fhk/plantz/README.md

# plantz
An example project and code to run a greenhouse (or maybe a local food revolution ...).

As always it's a Work In Progress (WIP).

Checkout the Twitch stream [coming soon] https://twitch.com

You can even fund some projects and the ongoing development of the urban distributed agriculutre concept. Sign up via Patreon [coming soon] https://patreon.com

As demand grows for high quality produce and the thirst for robust low impact supply chains expands a number of projects are being created to commercialize and educate the consumer. However, everyone should be able to create their own sustainable food source.

Some examples include:

- Paris, France - Agricool
- Bay Area, United States -
- MIT food computer V1, V2, V3 [link](https://wiki.openag.media.mit.edu/)
- Oroborus
- Monterey
- NY
- (Please add)

## What is Aquaponics?

TBC [link](https://www.youtube.com/watch?v=df5OrJptsWU)

## The Plan - v0.1 Backyard Greenhouse

### Lessons learnt

1. Insulate where possible the sump tank
2. It's very hard to holesaw PVC, try to use fittings instead
3. Assume you don't have wifi
4. Ensure you have multiple water routes
5. Design your circuits
6. You are at the mercy of water temp

### Planning

Prep the area, level it put down wire. Then create a frame to house the gravel/rock.

### Materials

1. 20 x 10ft Shelter Logic extra high greenhouse
2. 2" PVC pipe
4. 4 x 300 Gal. IBCs
5. 2 x 50 Gal. barrels with removable lids
6. 2 x 3-500 Gal. tanks
7. 1 x 20 Gal. Bucket
8. 20 x UniSeals
9. Rock/Media
10. Dow Blue Board Foam
11. 2" PVC Couplers
12. 2" PVC Ts
13. 2" PVC X
14. 4 x 2" PVC union joints
15. 4 x 2" PVC male threads
16. 2" PVC 90'
17. 2" to 3/4" adapter female to male
18. 4 x 3/4" X manifold female 
19. 12 x 12v 3/4" solenoid / Function wise it may be better to just get the 2" Krain 24V valves
20. Solderable bread board
21. Male and Femal terminals crimp on
22. Red and Black small gauge wire
23. Multi Colored medium gauge wire
24. 2 X Sparkfun Particle Photon
25. 12v Power supply
26. 5V activated 4 Relay board
27. 2 x Xaomi ip cameras
28. 4 x temp prope
29. 1 x humidity prope
30. Pure loctite silicone (No anti-fungal agents)
31. Bio balls
32. Air pump
33. 3 x large airstones
34. Large water pump
35. 20 x Cinder blocks
36. PVC Glue - Not too hot...
37. Solder
38. Extension cable
39. Powerboard
40. 2" PVC Valves
41. 4 x Pallets
42. Chicken wire
43. 2x2" Timber to make frame for cover
44. Pool noodles
45. Hyropoinc 2" baskets
46. Rockwool cubes
47. 1 Gallon/ 4 Litres white paint
48. Dish washing liquid
49. Plumbing thread tape
50. Perlite
51. Hydroponic buckets
52. Rockwool cubes
53. Iron supplement
54. Fish food

### Tools
1. Drill
2. 2" & 3" holesaw
3. PVC pip cutter
4. Allen keys
5. Socket set
6. Skrew drivers
7. Angle grinder
8. Stanley knife
9. PH meter
10. Sand paper
11. Garden hose
12. Soldering iron
13. Pole and paint applicator
14. Sharpie
15. Pressure washer

### How to

#### The plan

The overall design evolved as it was built but I am realtivly confident that it is in a stable state now.

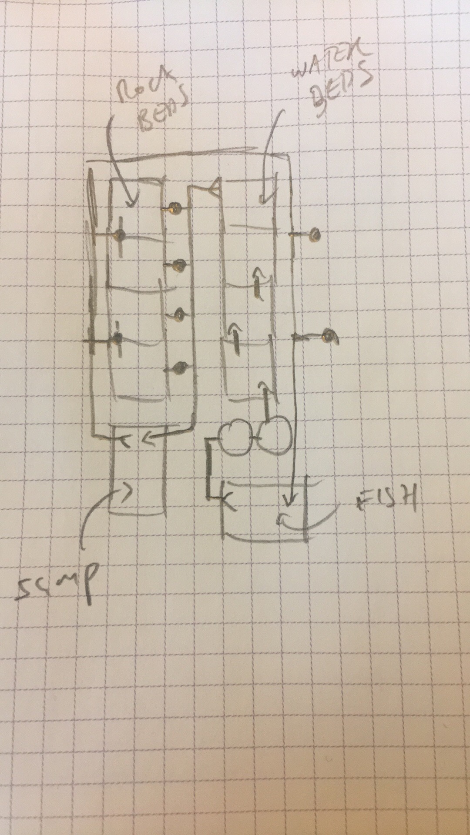
[picture p1: assets/img/IMG_4307.JPG]


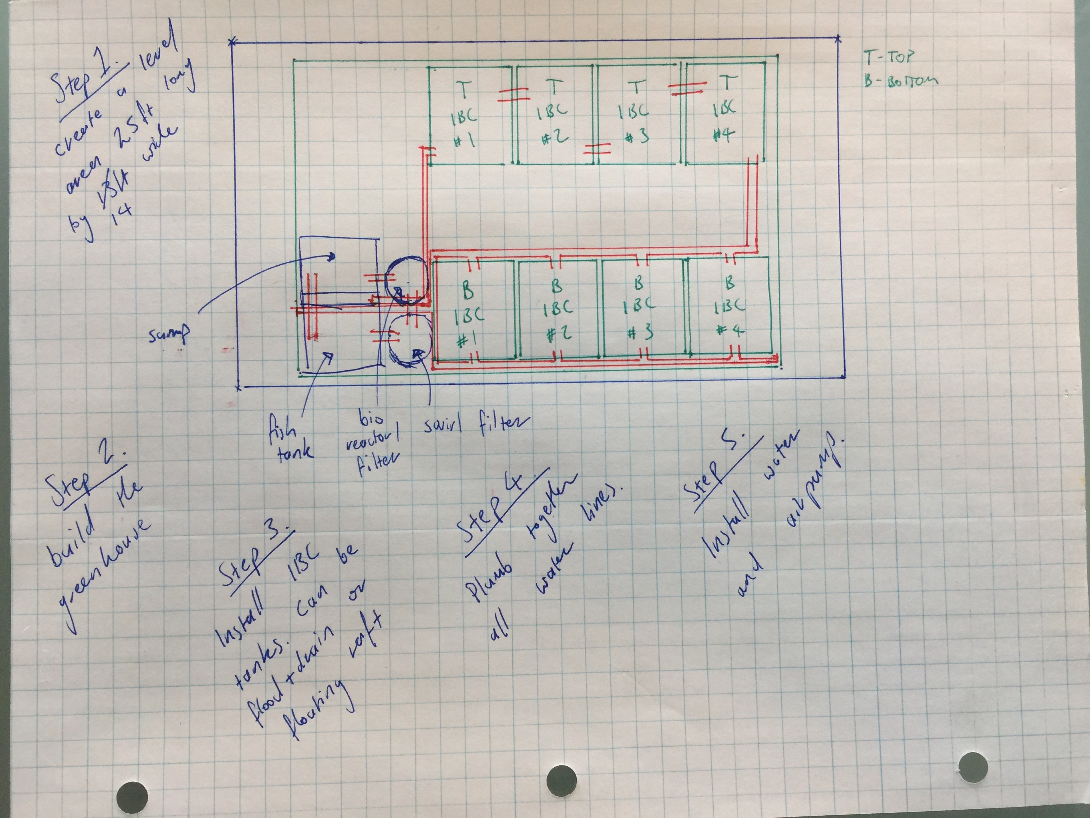
[picture p2: assets/img/IMG_1213.JPG]


#### Step 1 - Build the greenhouse

Select an area and get it levelled off and make sure the bottom is well draining.

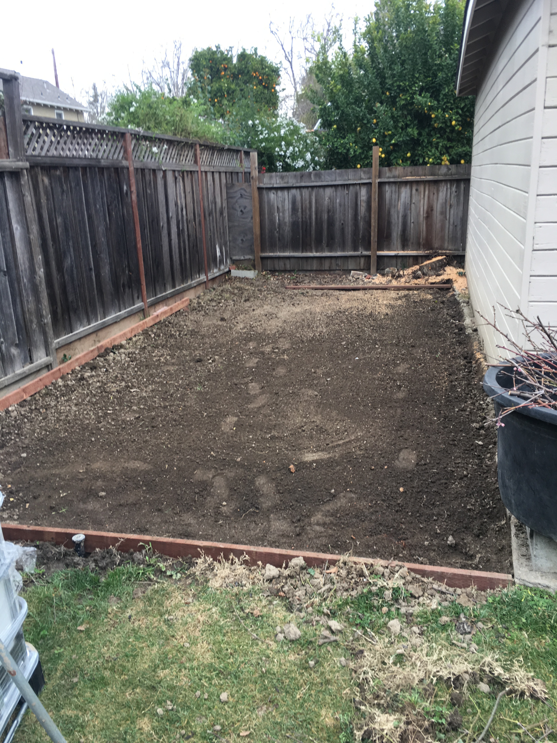
[picture p3: assets/img/IMG_4750.JPG]

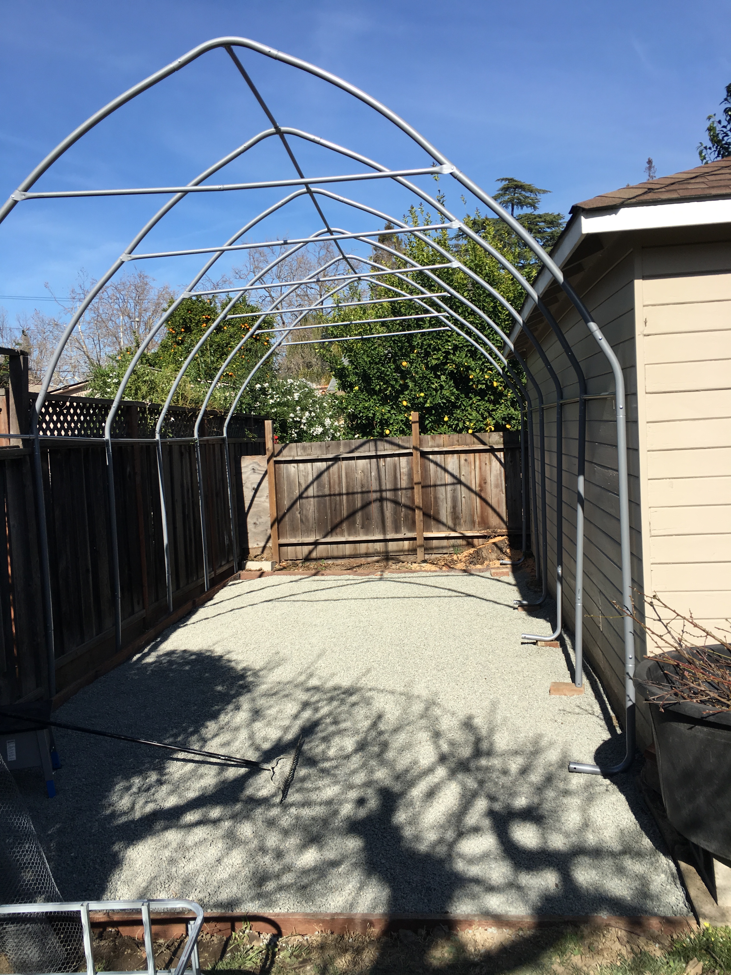
[picture p4: assets/img/IMG_9652.JPG]


This [video](https://www.youtube.com/watch?v=2YyyYJgxaFM) shows the process. Note be sure to measure the space. In our case we had to leave out one section due to a leaning fence.

You you will need at least 2 people.

#### Step 2 - Cut the IBCs in half

First be sure that they are clean. If not use a pressure washer to clean them.

1. Take the IBCs out of their metal cages - keep the metals bars as they will be used later.
2. Use a string line and sharpie to mark all 4 sides of the container.
3. Cut them with the angle grinder using a cutting disk.
4. Trim the extra metal such that it is not pertruding.
5. Mount the top half of the metal cages to the 4 pallets.
6. Replace the 1/2 IBCs into the 8 pallet holders/containers.

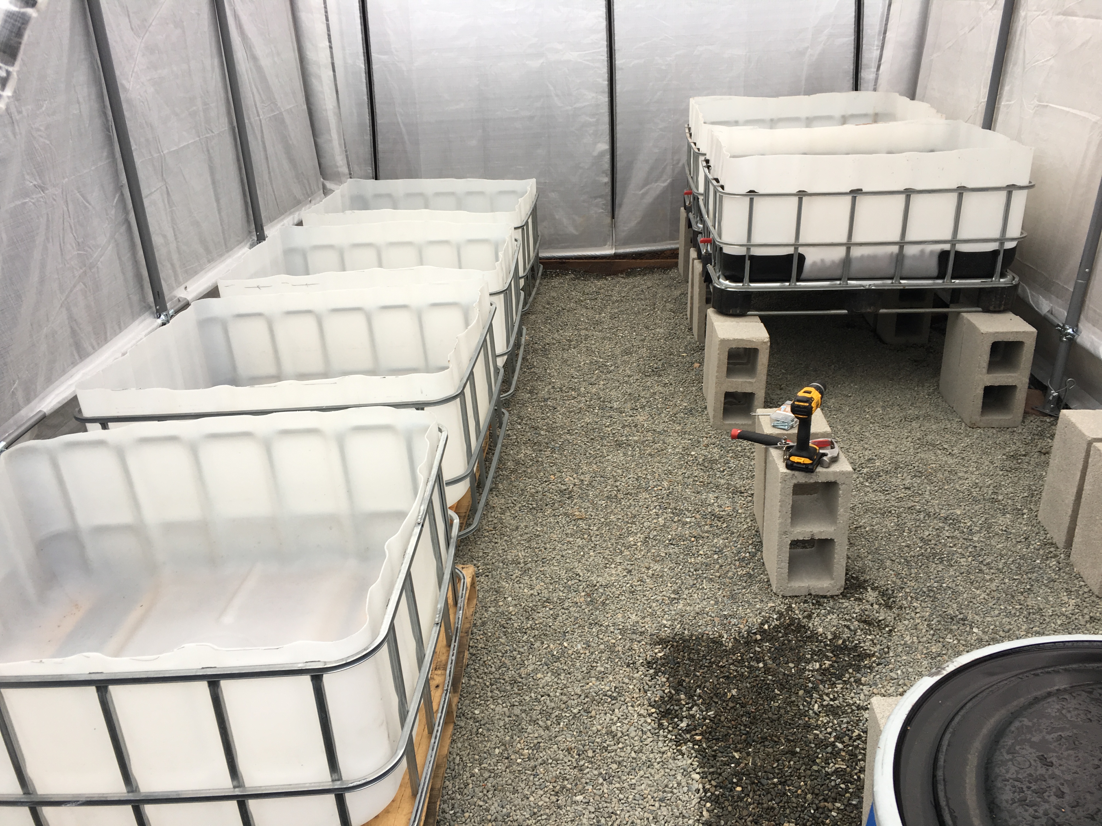
[picture p5: assets/img/IMG_3498.JPG]


#### Step 3 - Wash the rocks

Depending on what media you have selected its a great idea to wash them such that minimal debris is present.

You can use two of the IBCs and place them at an angle such that the water drains through the valve.

Use the pressure washer and add the rocks as you clean them.

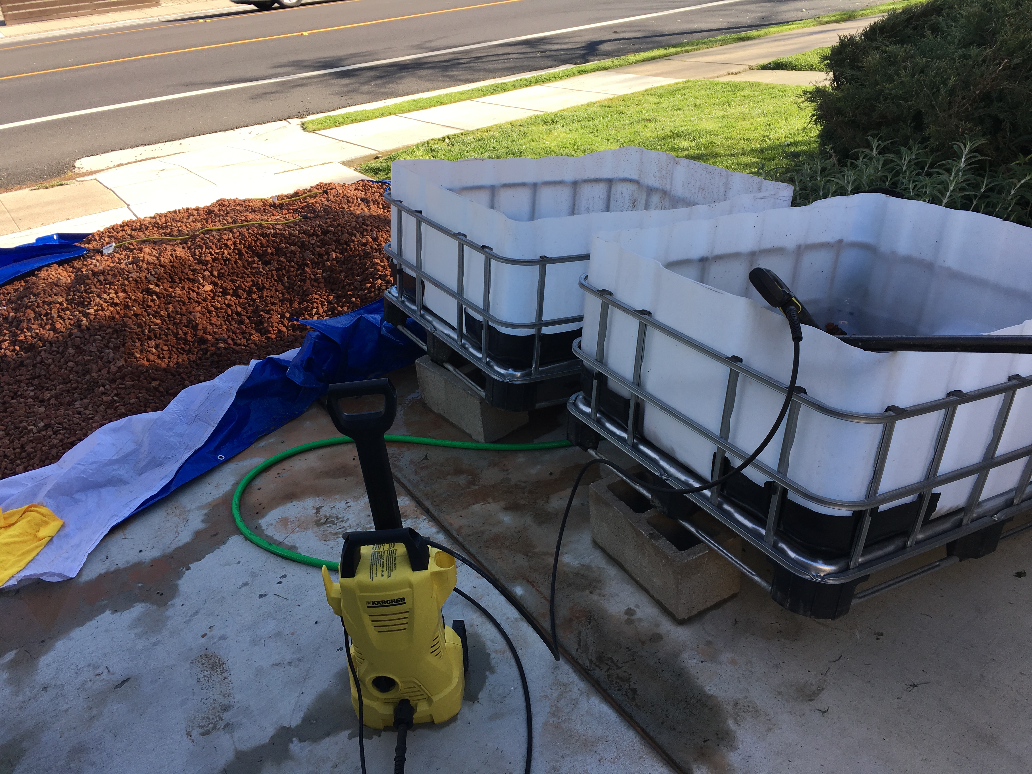
[picture p6: assets/img/IMG_0695.JPG]


#### Step 4 - Setup the water flow

Now we want to create the water flow for the setup.

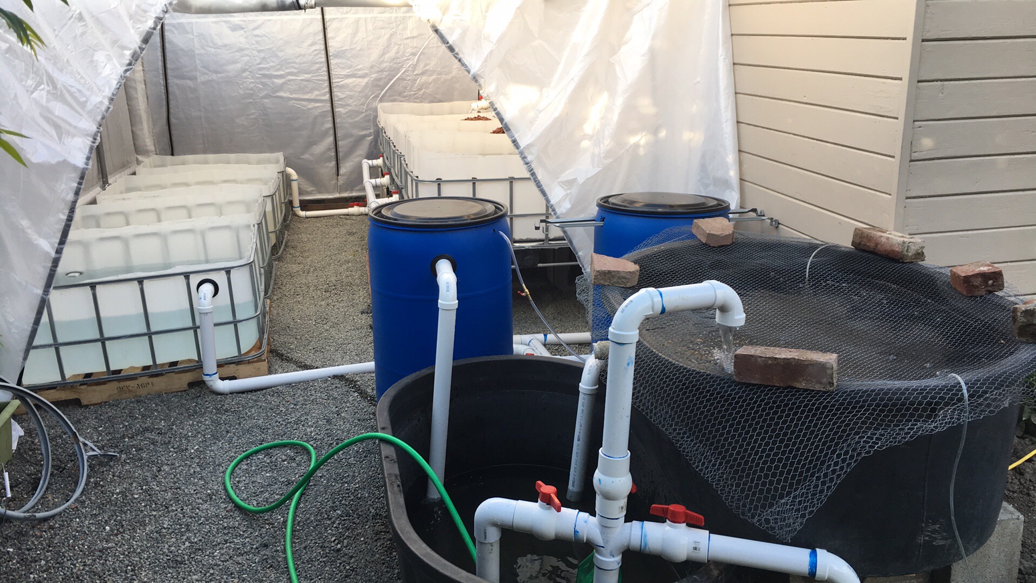
[picture p7: assets/img/IMG_4515.JPG]


1. Place the deep water culture IBCs on the side of you preference.
2. Place the cider blocks in groups of four such that you can place the IBCs with original bottoms on them.
3. Determine your water route
4. Use the holesaw to cut the desired holes
5. Install the uniseals
6. Cut the PVC to length and glue the required sections
7. Trim the PVC so that it has a taper with a stanley knife
8. Use dish soap to push the PVC through
9. Move the rock IBCs to their positions
10. Attache the union joints using thread tape to get a good seal
11. Create the top water dispenser manifold
12. Create the bottom water manifold
13. Connect the water manifolds to the tank and pump outlet
14. Create the swirl filter

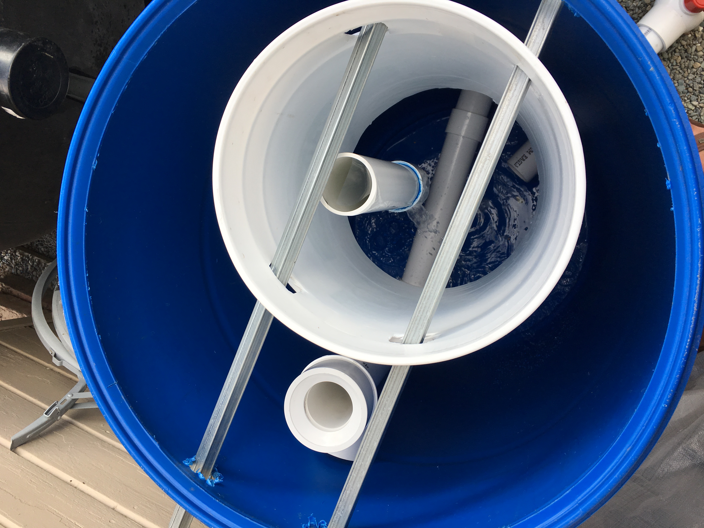
[picture p8: assets/img/IMG_2832.JPG]


15. Create the bioreactor

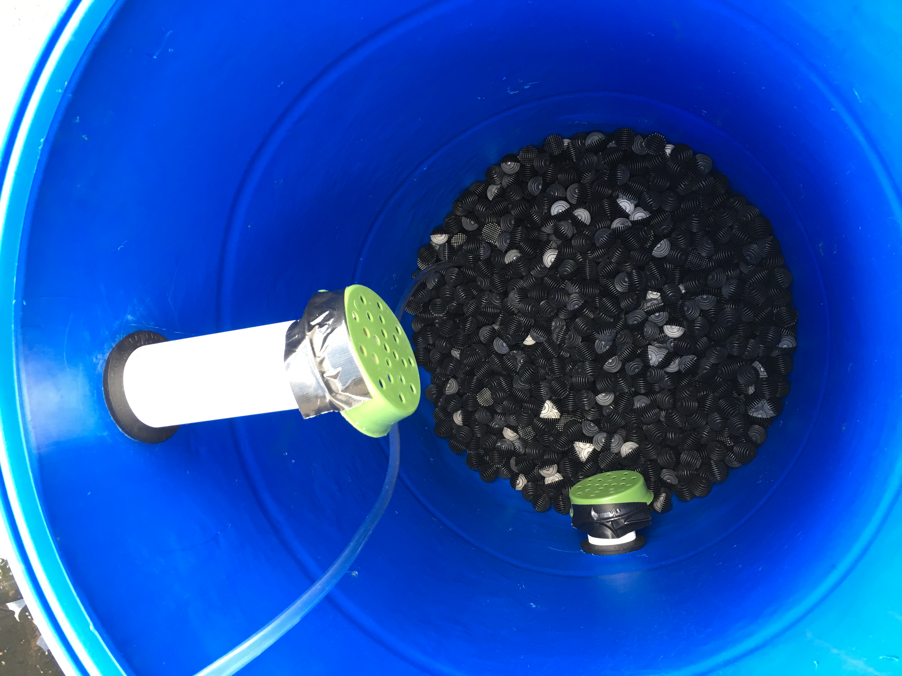
[picture p9: assets/img/IMG_7655.JPG]


16. Install the airpump and stones
17. Install the pump and connect to water inlets
18. Begin water filling and cycling, fill the deep water IBCs first

The system should now be cycling and you can add the fish once you are comfortable with the flow and water quality.

#### Step 5 - Create floating rafts

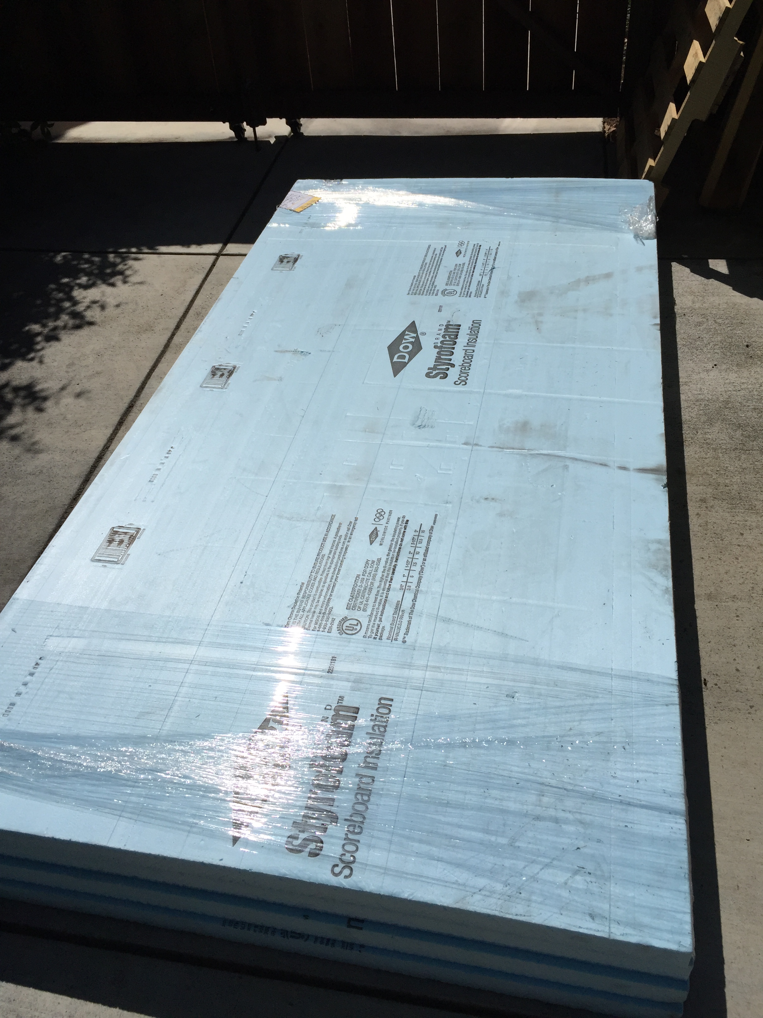
[picture p10: assets/img/IMG_0008.JPG]


Paint the tops of the boards.

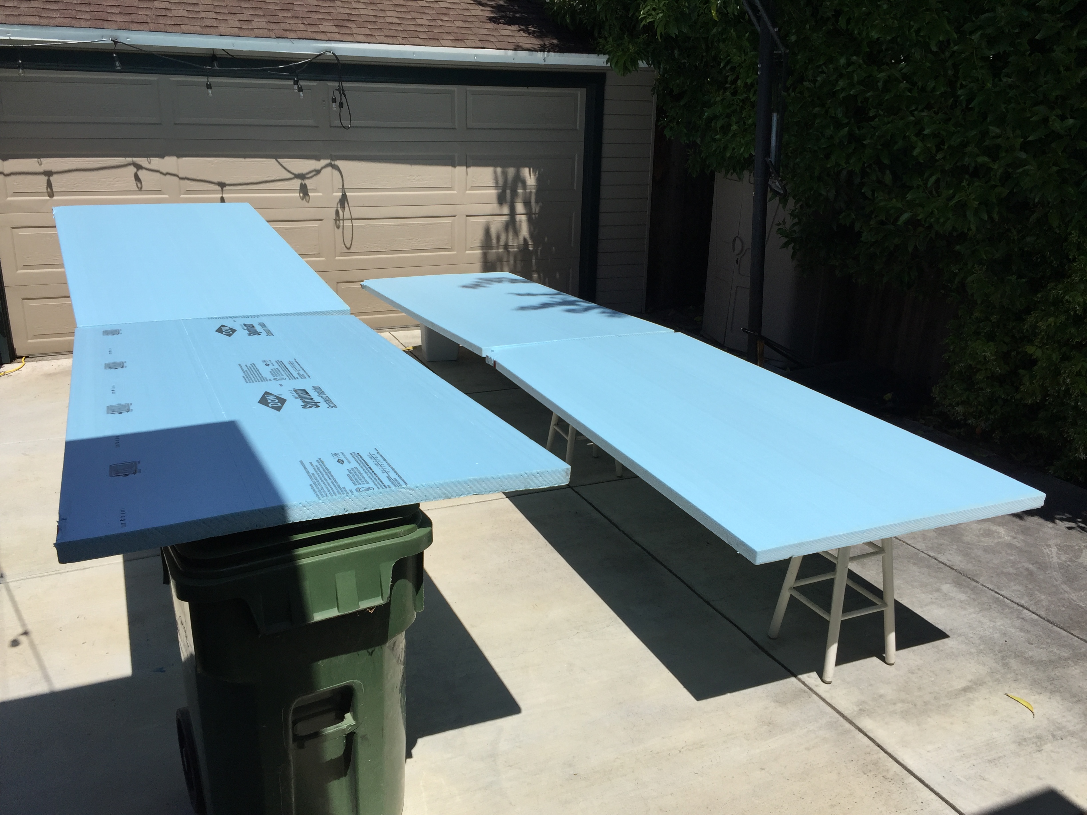
[picture p11: assets/img/IMG_0010.JPG]


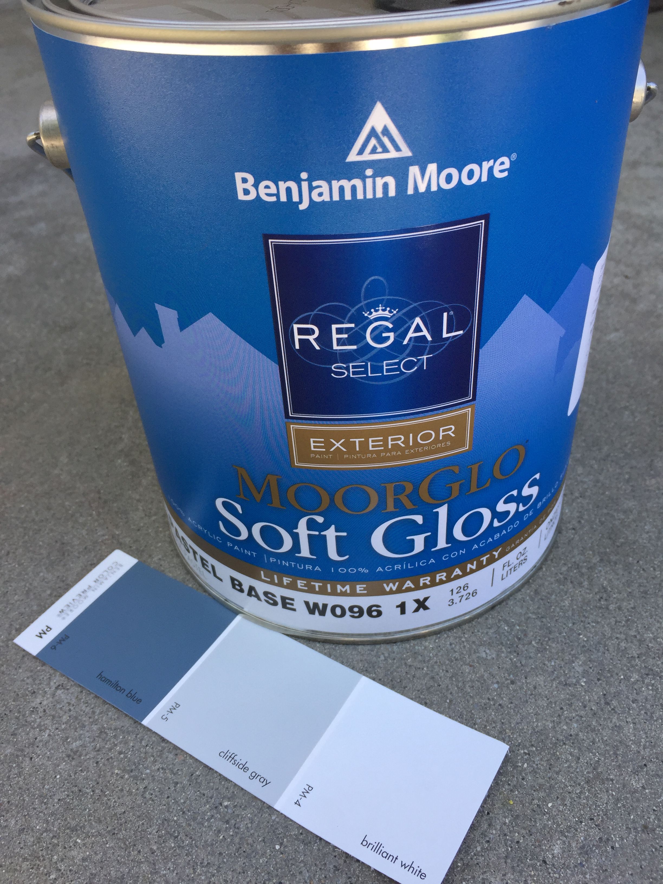
[picture p12: assets/img/IMG_0011.JPG]


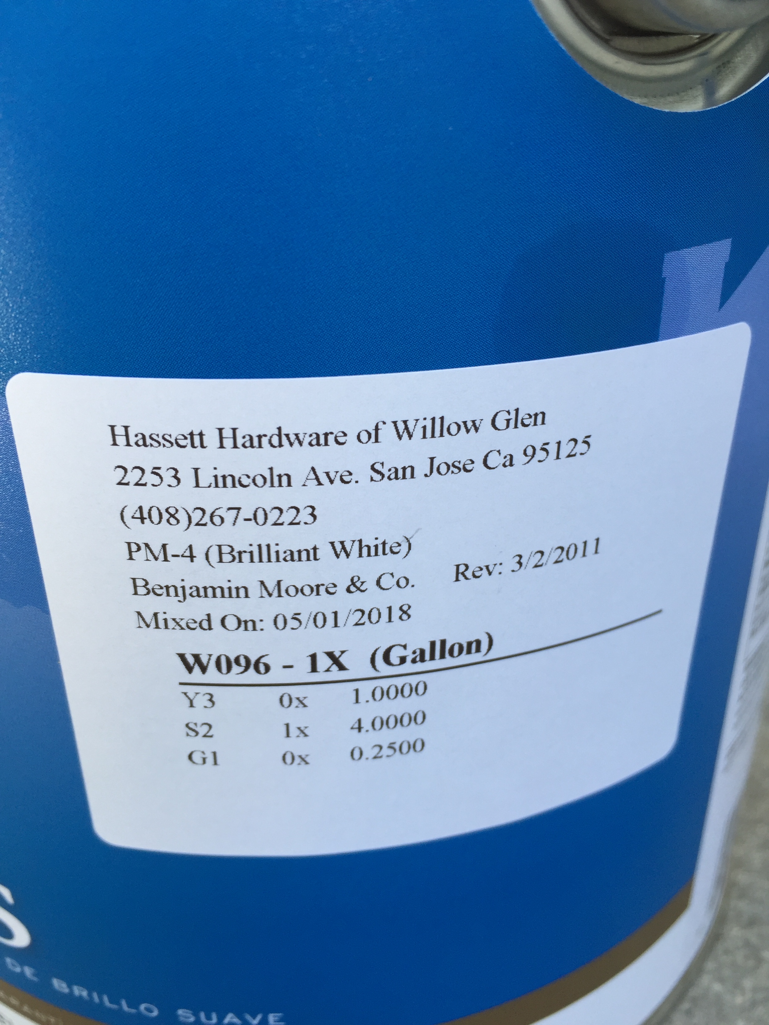
[picture p13: assets/img/IMG_0012.JPG]


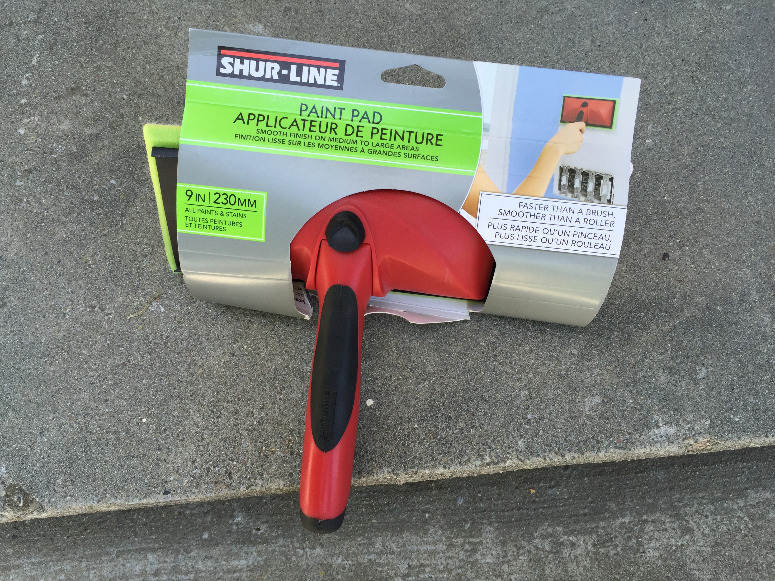
[picture p14: assets/img/IMG_0013.JPG]


Measure out the Dow Blue board and cut it with a sharp knife, angle grinder or multi tool.

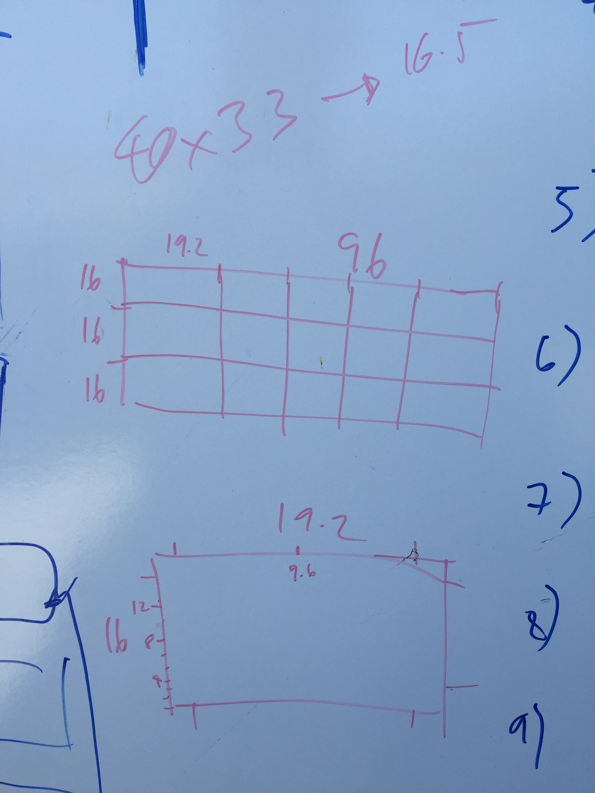
[picture p15: assets/img/IMG_0009.JPG]


Create the 2" hole for the planting. Create a offset pattern depending on what you intend to grow.

Keep the hole cut outs as you may want to place them back in to grow in alternate configurations.

#### Step 6 - Water manifolds and sensing

Create the water manifolds with the solenoids.

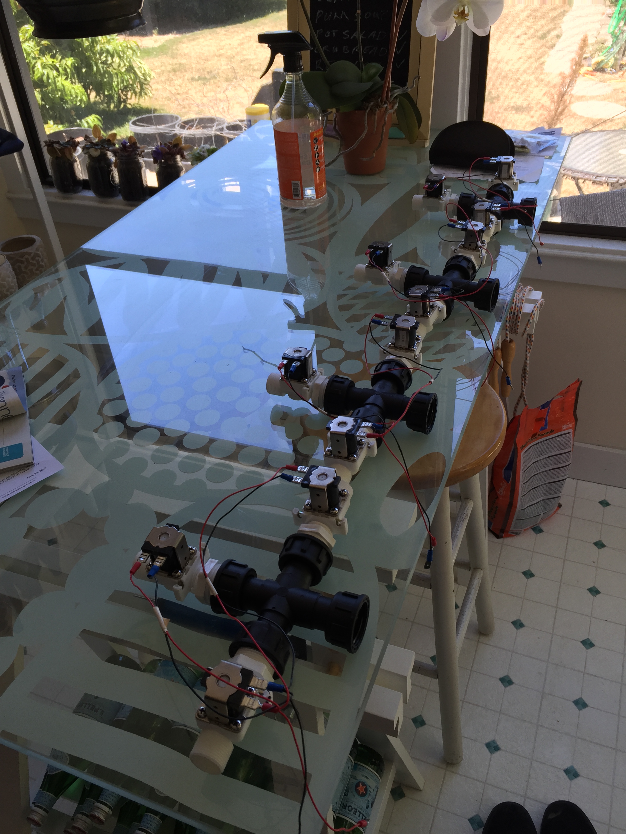
[picture p16: assets/img/IMG_0305.JPG]


Attach them to the top water pipes.

Using the particle board, connect it to the relay module and program it to cycle.

Using another particle add the temp, humidity, light and any other sensors you'd like. (TODO)

Run the wiring and solder where neccasary.

### Fish

In order of ease:

1. Gold fish
2. Koi

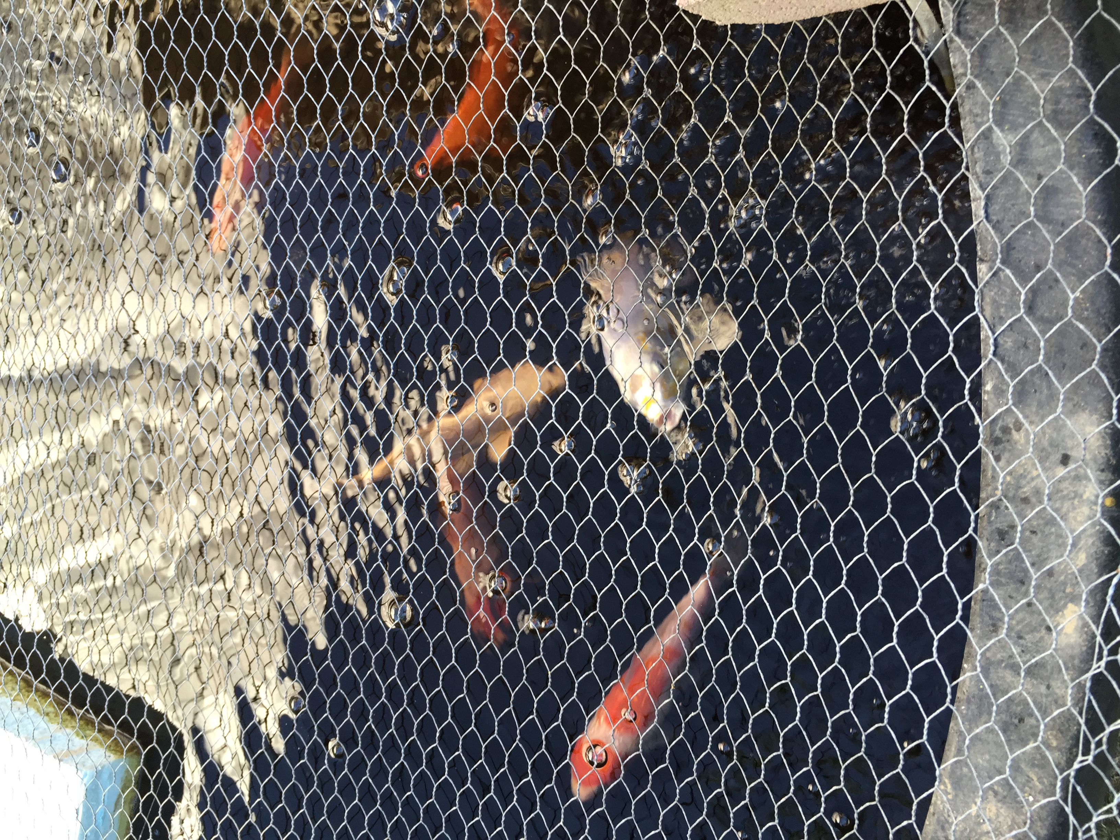
[picture p17: assets/img/IMG_0443.JPG]


3. Talapia (Temp and water quality can be challenging)
4. Trout (Temp and water quality can be challenging)

### Operations & Maintaince

TODO

#### Seeds

TODO

#### Planting

TODO

#### Feeding calculation v. ease

TODO

#### Filtration

TODO

#### Nutrients

TODO

### Year 1 Crop

#### Summer

Using only the floating rafts we were able to grow an extrodinary amount of:

- Basil
- Tomatoes (planted too late)
- Edamamae
- Thai basil
- Mint
- Parsely
- Cellery

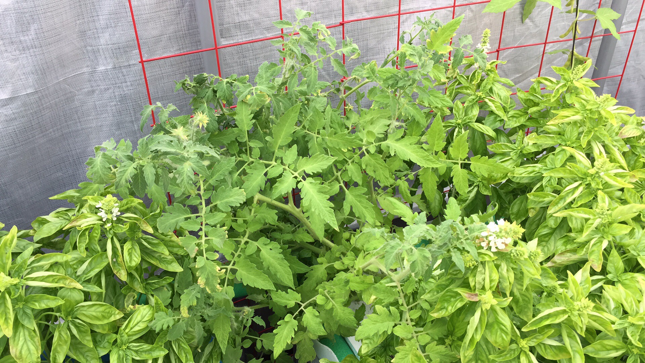
[picture p18: assets/img/IMG_0450.JPG]

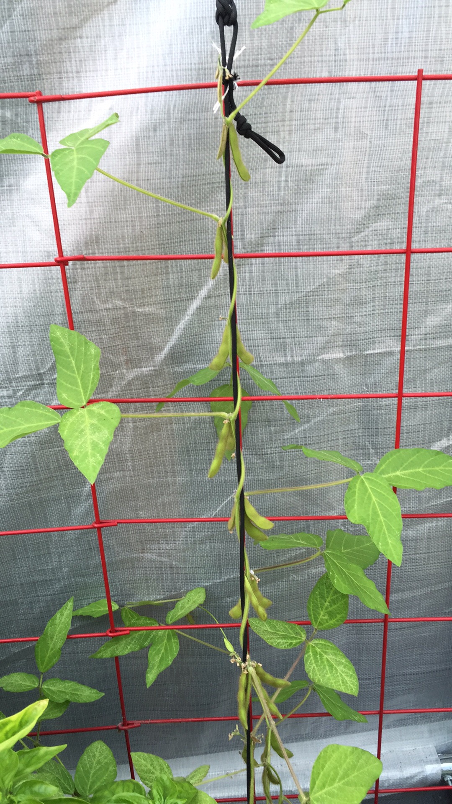
[picture p19: assets/img/IMG_0449.JPG]

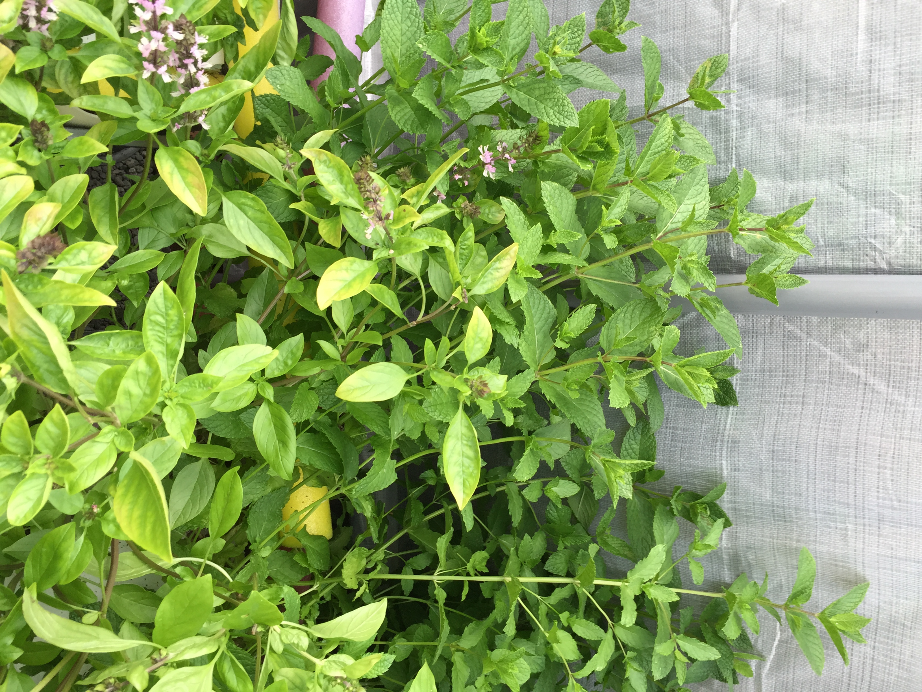
[picture p20: assets/img/IMG_0448.JPG]

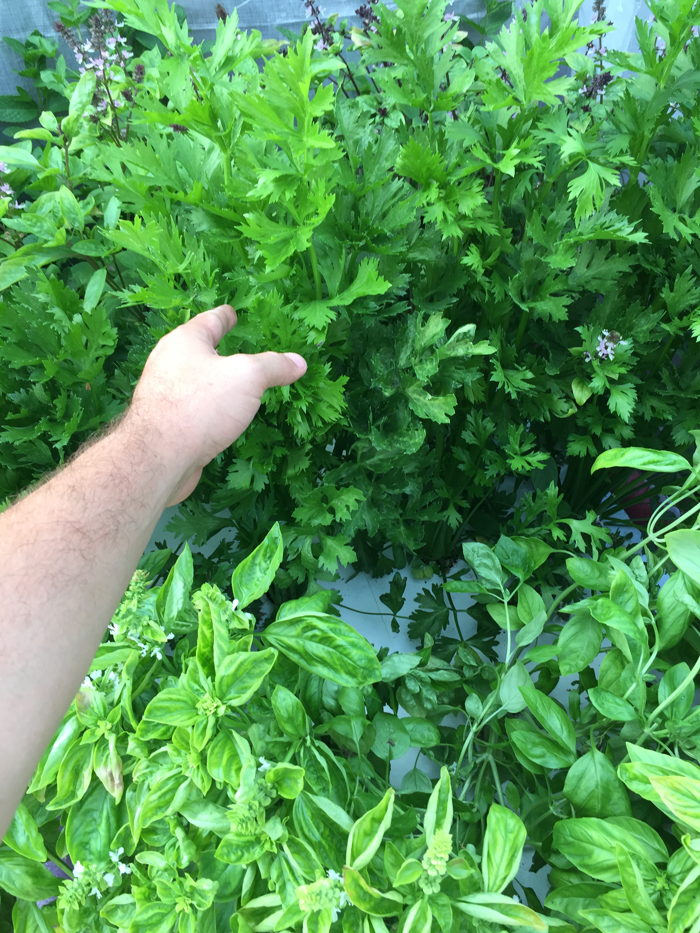
[picture p21: assets/img/IMG_0447.JPG]


### Year 2 Crop

#### Winter

- Salad
- Lemon balm
- Thyme
- Parsely
- Cauliflow
- Collard greens
- Peas (planted late)

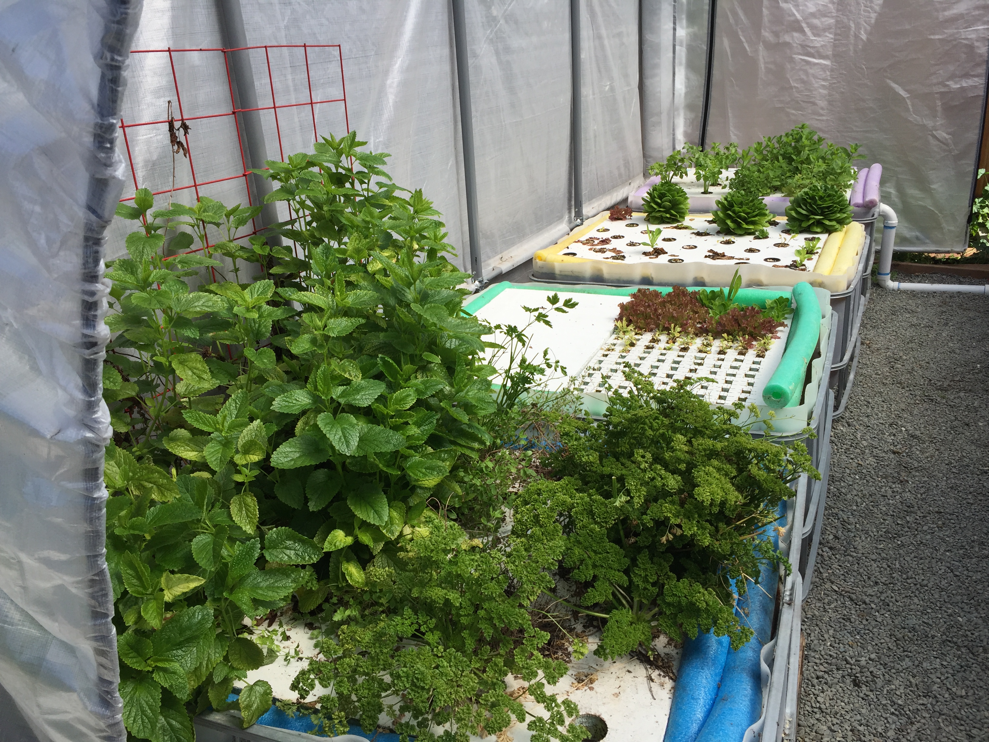
[picture p22: assets/img/IMG_1275.JPG]


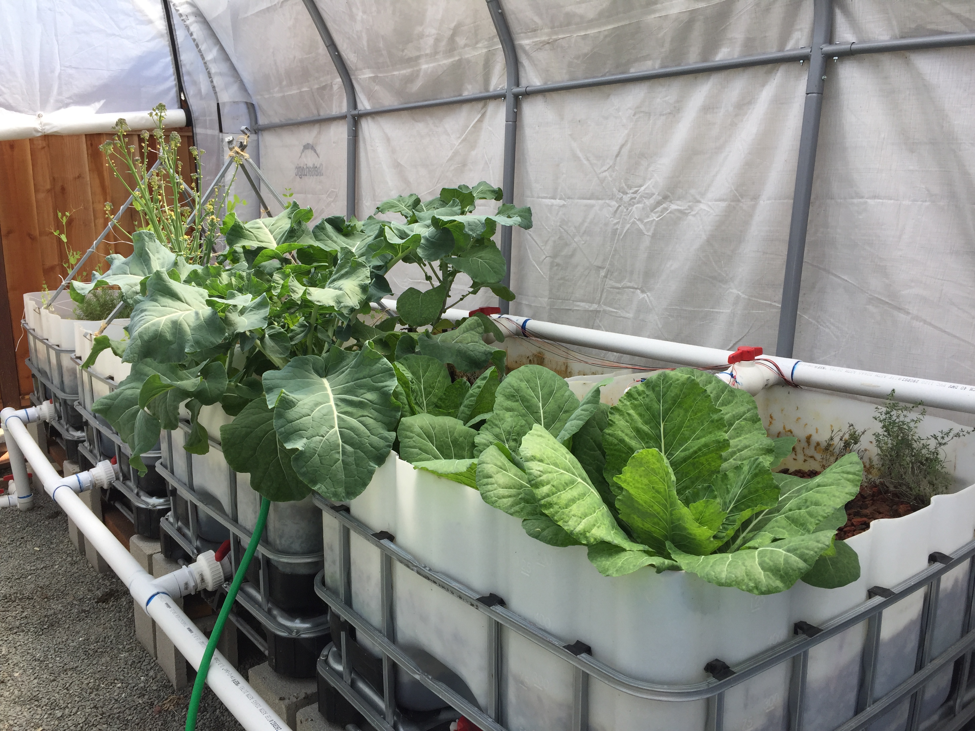
[picture p23: assets/img/IMG_1276.JPG]


## (Coming Soon) For Real - v0.2 20 and 40ft containers! (Maybe...)

Building out vertical solutions in a container that can be delivered to you or a driveway near you.

## DIY v. OTS

There are a number of items and even complete systems that you can buy. I have taken a very DIY centric approach to ensure that costs are kept low.

This has however, created a number of challenges and made some things take longer as I looked for solutions.

## Future enhancements

1. Proper sealing
2. Cameras
3. Heating and cooling
	1. https://www.overclockers.com/extreme-water-cooling-using-refrigeration/
	2. Evaporative
	3. HVAC $$$?
	4. Cooling wall
4. Add vertical growing ala [zip grow](https://zipgrow.com/)
5. Add aeroponics [link](https://hackaday.io/project/12398/instructions)
6. Add fully automated robotic crop maintaince - [farmbot](https://farm.bot)
7. Live camera streaming and image object detection plus localization/masking. [hack](https://hackernoon.com/hacking-a-25-iot-camera-to-do-more-than-its-worth-41a8d4dc805c)

## References

1. https://docs.particle.io/reference/firmware/electron/#udp
2. https://community.particle.io/t/robust-udp-communications/17218
3. https://wiki.python.org/moin/UdpCommunication
4. https://docs.python.org/3/library/datetime.html
5. https://github.com/sparkfun/Inventors_Kit_For_Photon_Experiments/tree/master/03-PlantMonitor
6. https://www.agritecture.com/
7. https://www.youtube.com/channel/UCFUk9FLx4lb-WhfoY-STxDQ
9. https://www.hackster.io/LuisLabMO/smart-modular-watering-system-b571ec
10. https://www.plenty.ag/
11. https://wefunder.com/element.farms/
12. https://www.youtube.com/watch?v=6vcmIzYI0po
13. https://cannabusinessplans.com/much-cost-grow-cannabis-indoor/
14. http://www.autonomousgreenhouses.com/
15. https://topdocumentaryfilms.com/rise-vertical-farming/
16. https://cloudponics.com/
17. https://youtu.be/AkMGH9910eM
18. https://youtu.be/-yAcD3wuY2Q
19. https://twitter.com/_agricool/status/880420268837134338
20. https://www.youtube.com/watch?v=w-1tBWDHcQs&feature
21. https://www.greenthumb.io/
22. https://experiments.withgoogle.com/oasis
23. https://www.youtube.com/watch?v=XWUt6hT_8Lo
24. http://dachnikaquaponics.com/
25. https://www.youtube.com/watch?v=LuPGJLE6BdY
26. https://www.uvi.edu/files/documents/Research_and_Public_Service/WRRI/UVIAquaponicSystem.pdf
27. https://mitpress.mit.edu/books/eat-cook-grow
28. https://automicrofarm.com/
