fhk/plantz/assets/img/IMG_0007.JPG

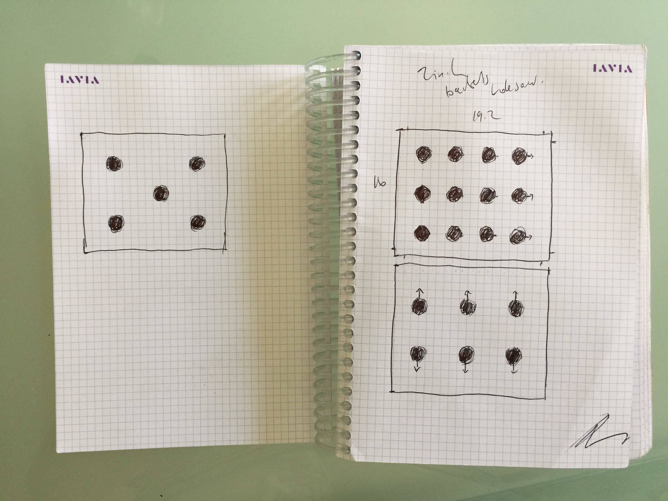
assets/img/IMG_0007.JPG
