fhk/plantz/assets/img/IMG_0014.JPG

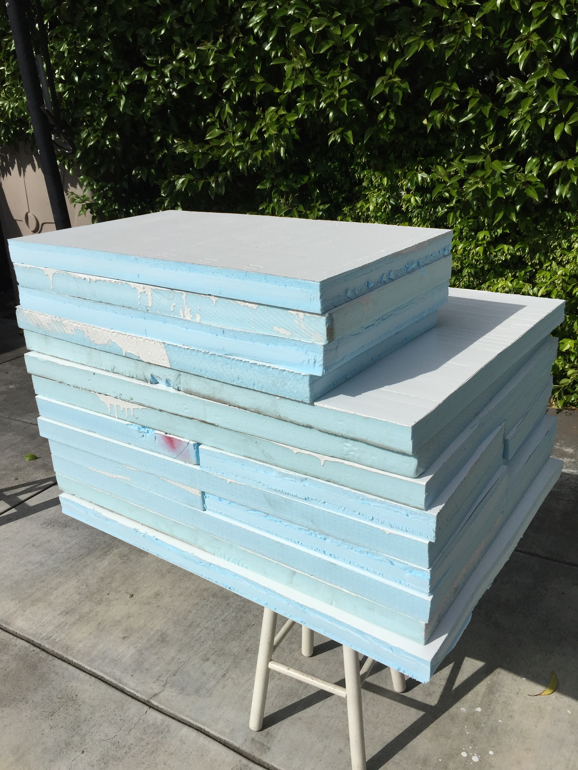
assets/img/IMG_0014.JPG
