fhk/plantz/assets/img/IMG_0015.JPG

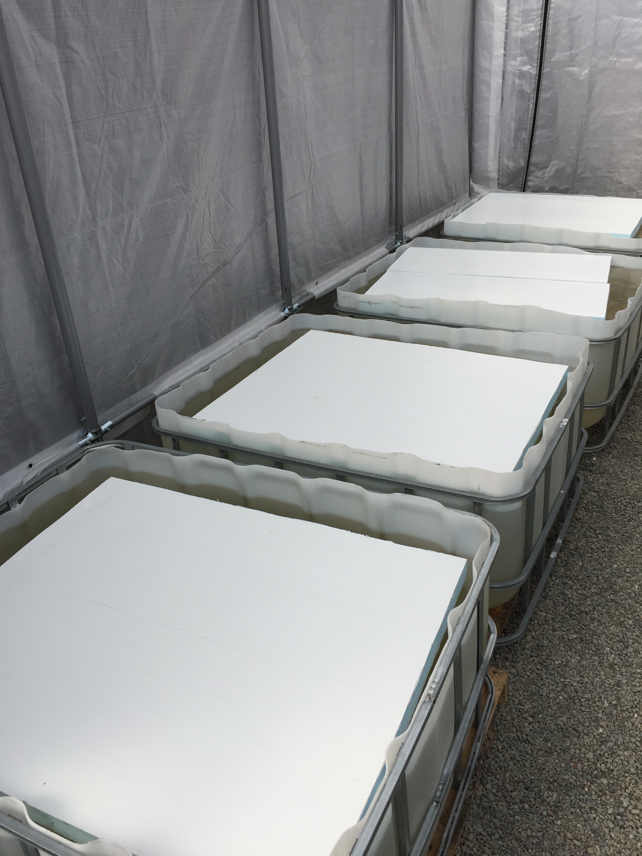
assets/img/IMG_0015.JPG
