fhk/plantz/assets/img/IMG_0058.JPG

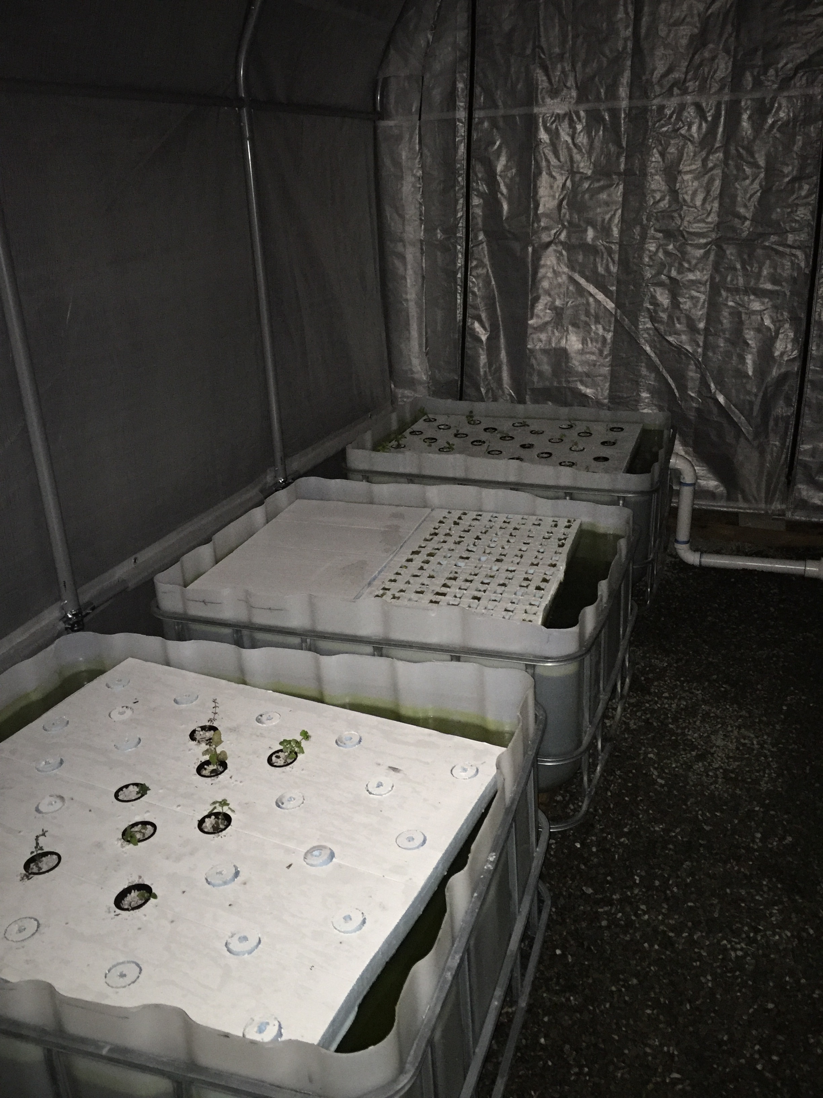
assets/img/IMG_0058.JPG
