fhk/plantz/assets/img/IMG_0208.JPG

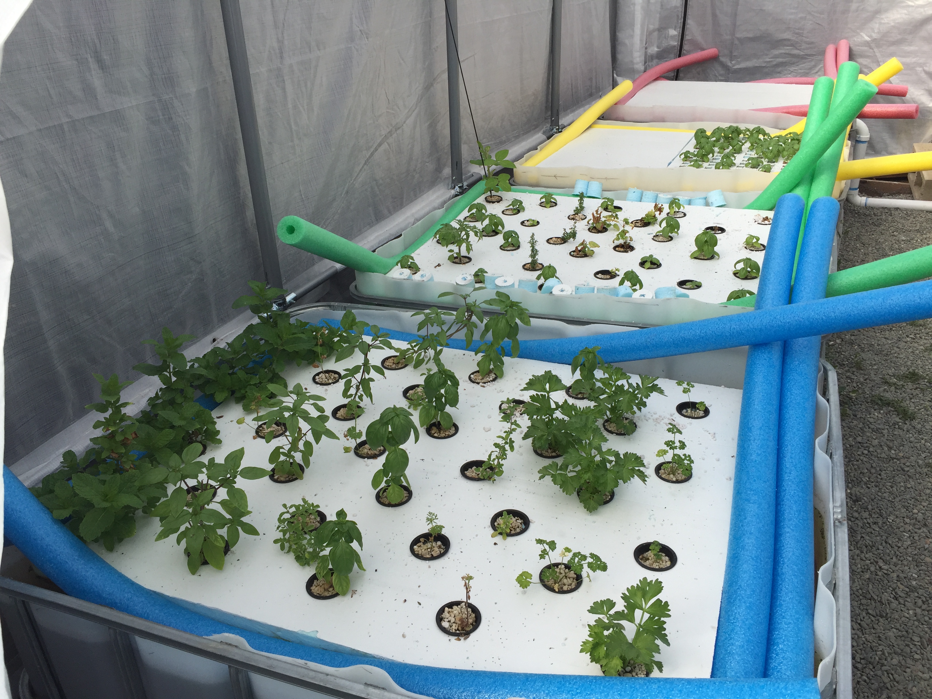
assets/img/IMG_0208.JPG
