fhk/plantz/assets/img/IMG_0239.JPG

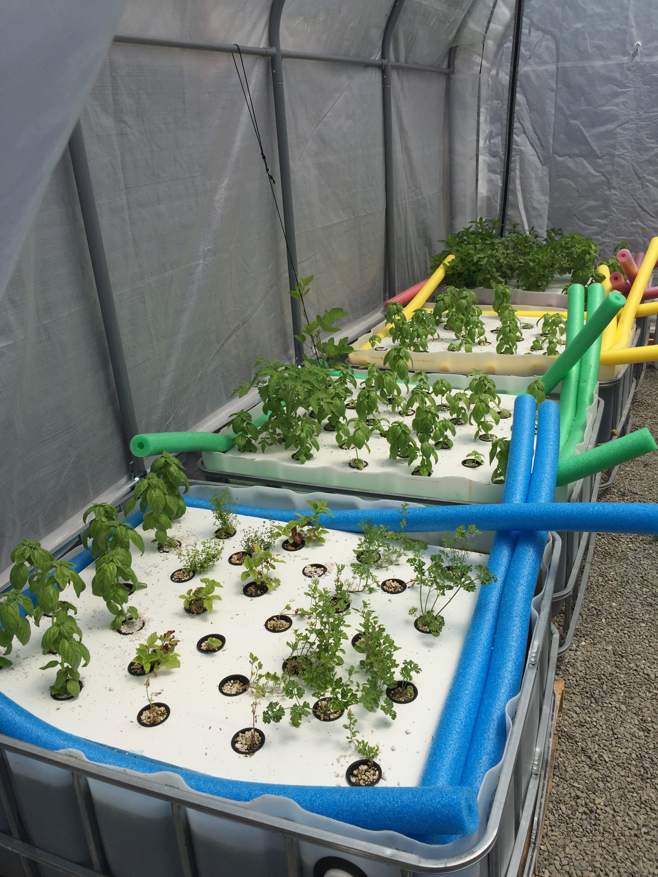
assets/img/IMG_0239.JPG
