fhk/plantz/assets/img/IMG_0306.JPG

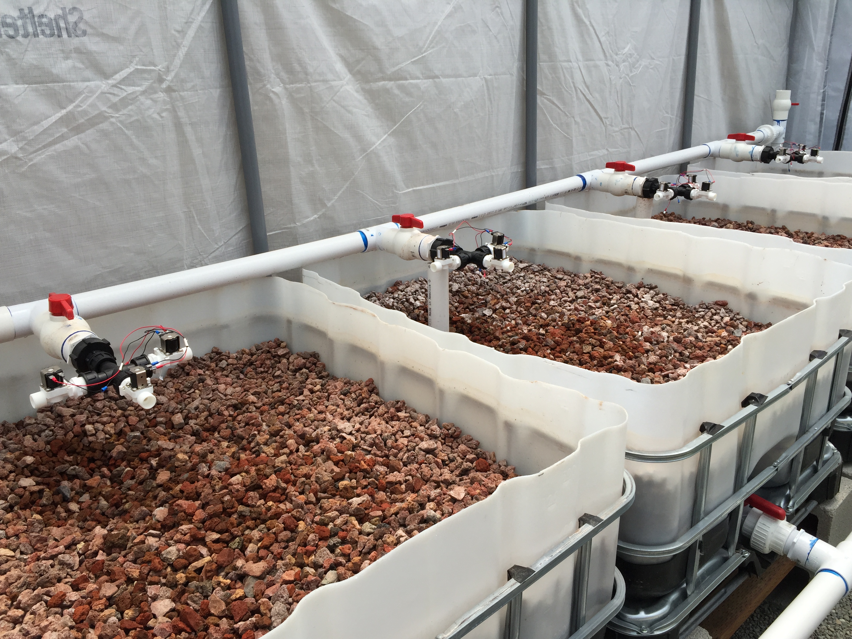
assets/img/IMG_0306.JPG
