fhk/plantz/assets/img/IMG_0442.JPG

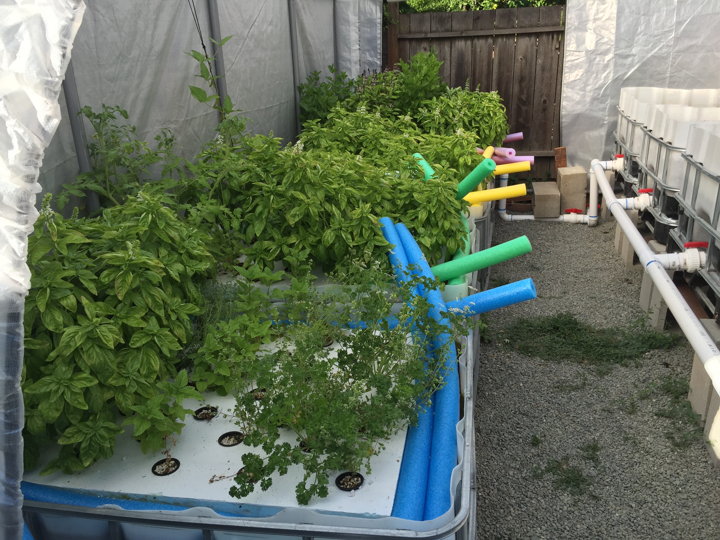
assets/img/IMG_0442.JPG
