fhk/plantz/assets/img/IMG_1347.JPG

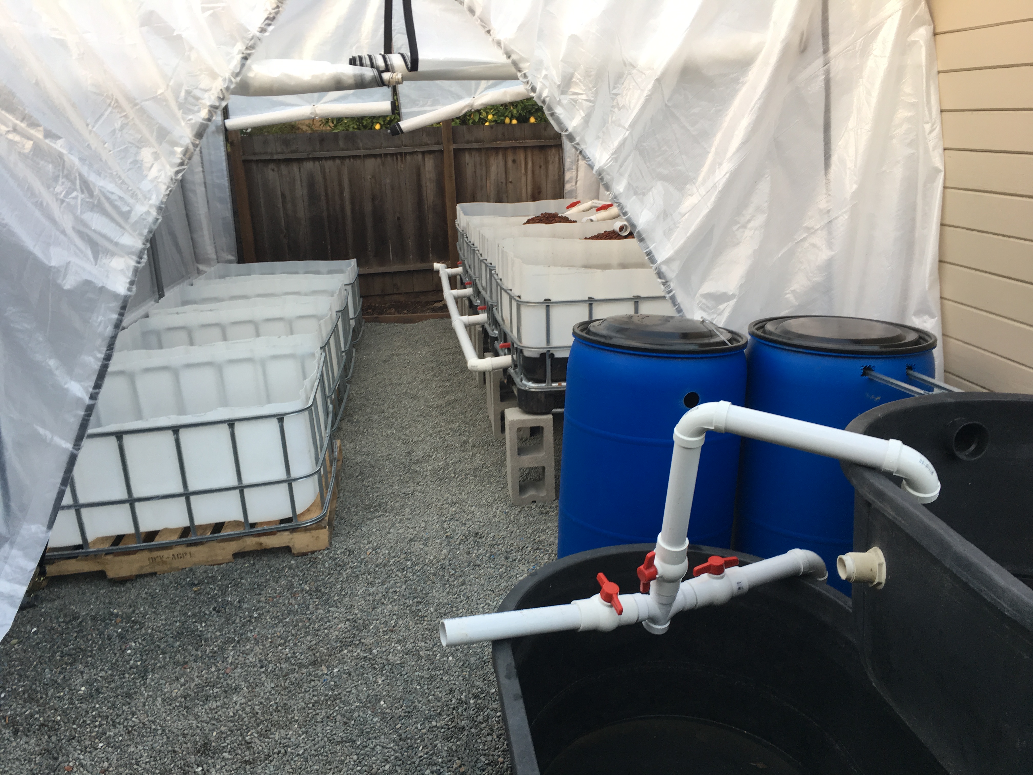
assets/img/IMG_1347.JPG
