fhk/plantz/assets/img/IMG_2219.JPG

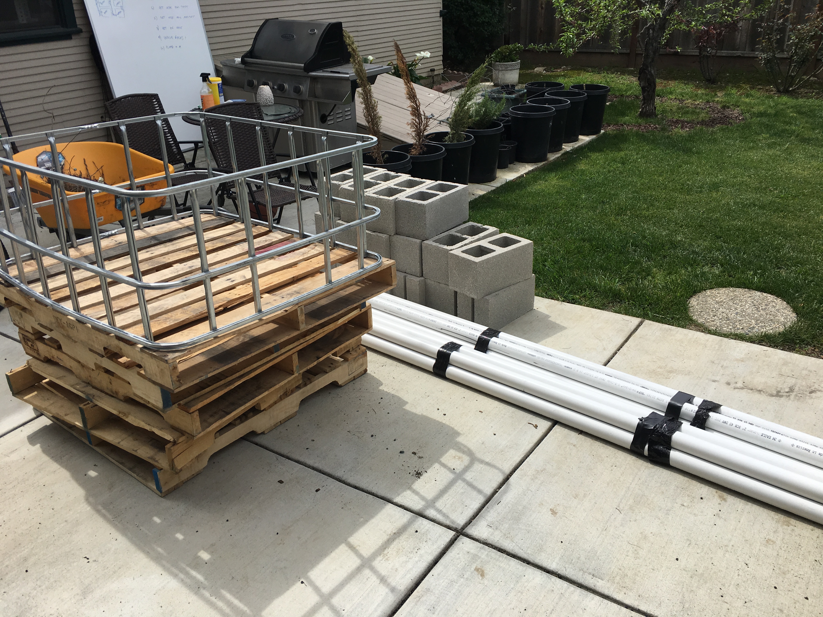
assets/img/IMG_2219.JPG
