fhk/plantz/assets/img/IMG_3548.JPG

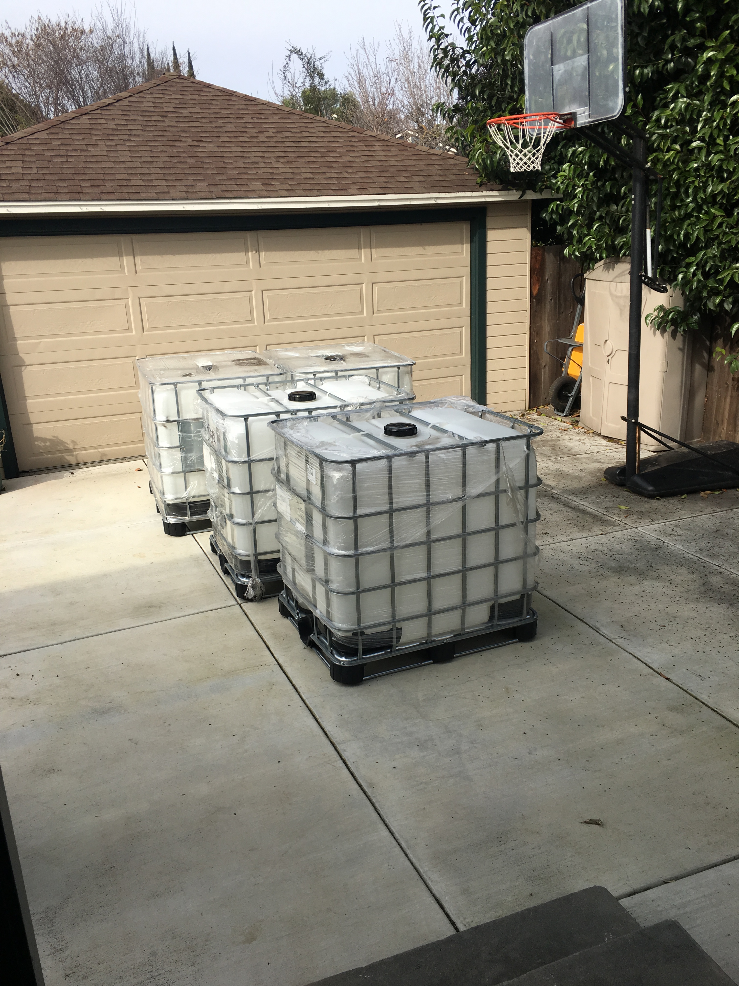
assets/img/IMG_3548.JPG
