fhk/plantz/assets/img/IMG_4308.JPG

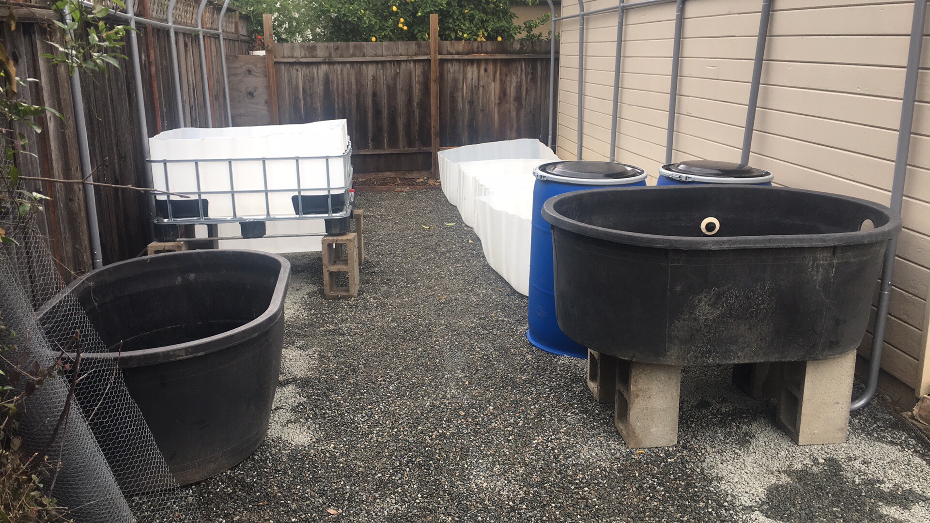
assets/img/IMG_4308.JPG
