fhk/plantz/assets/img/IMG_4387.JPG

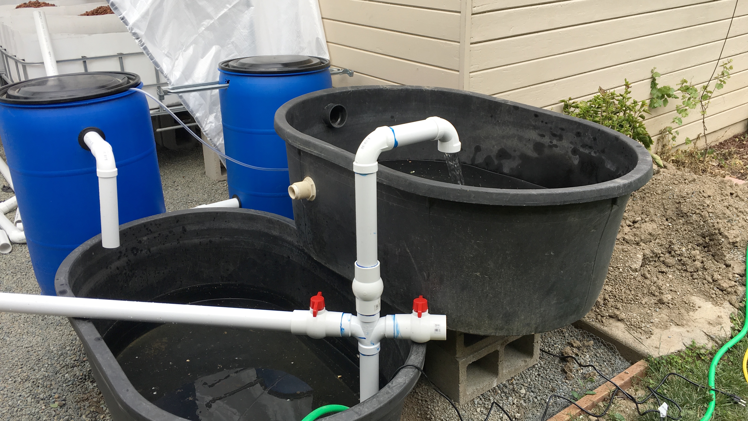
assets/img/IMG_4387.JPG
