fhk/plantz/assets/img/IMG_5308.JPG

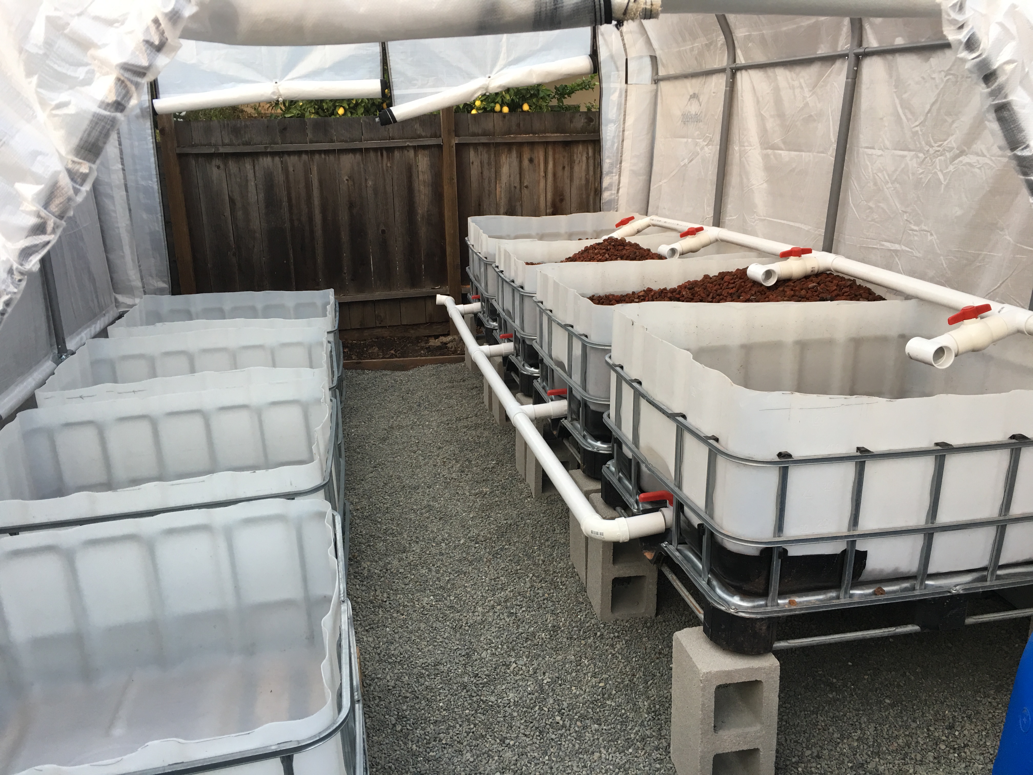
assets/img/IMG_5308.JPG
