fhk/plantz/assets/img/IMG_6784.JPG

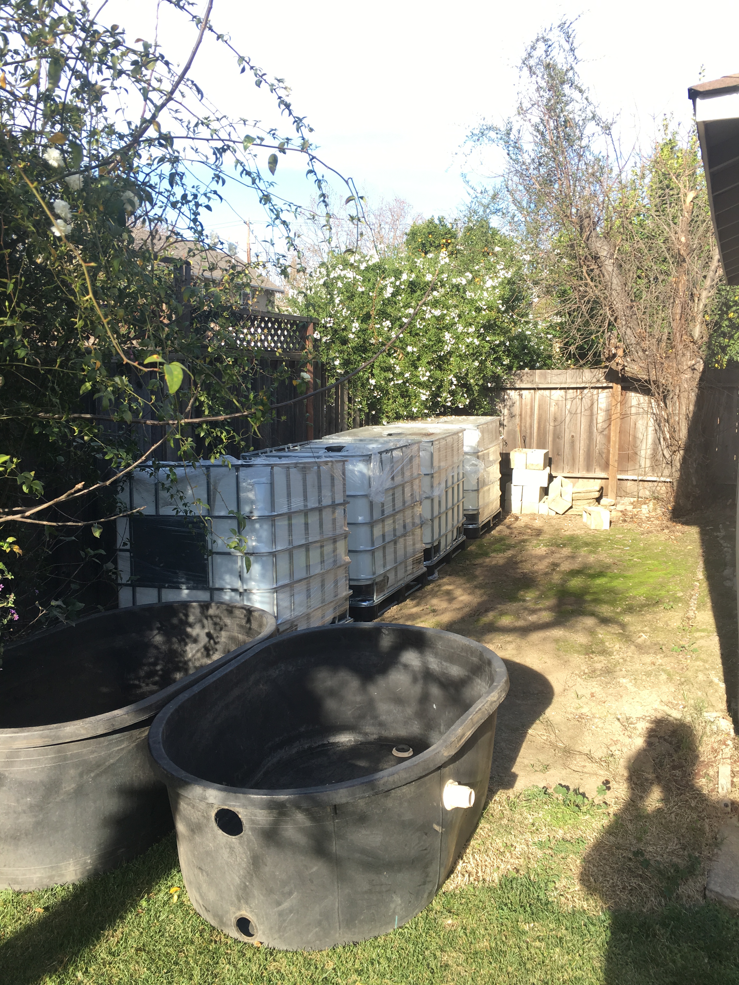
assets/img/IMG_6784.JPG
