fhk/plantz/assets/img/IMG_8967.JPG

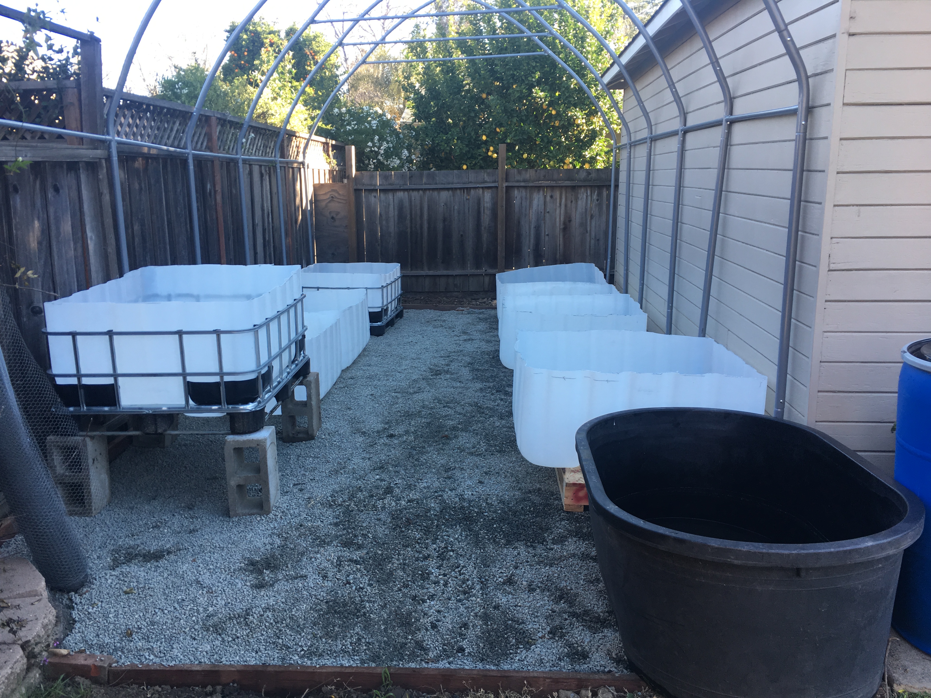
assets/img/IMG_8967.JPG
